KevinOleniczak/Windfarm-hardware/turbine/models/DC-Motor With Rotor/Render/Bearing2.jpg

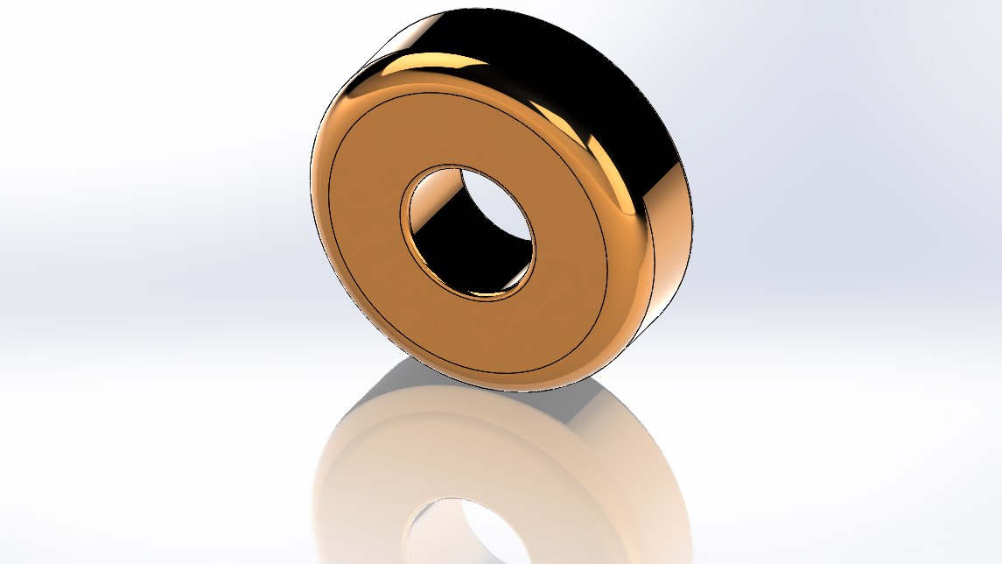
turbine/models/DC-Motor With Rotor/Render/Bearing2.jpg
