KevinOleniczak/Windfarm-hardware/turbine/models/DC-Motor With Rotor/Render/Bearing.jpg

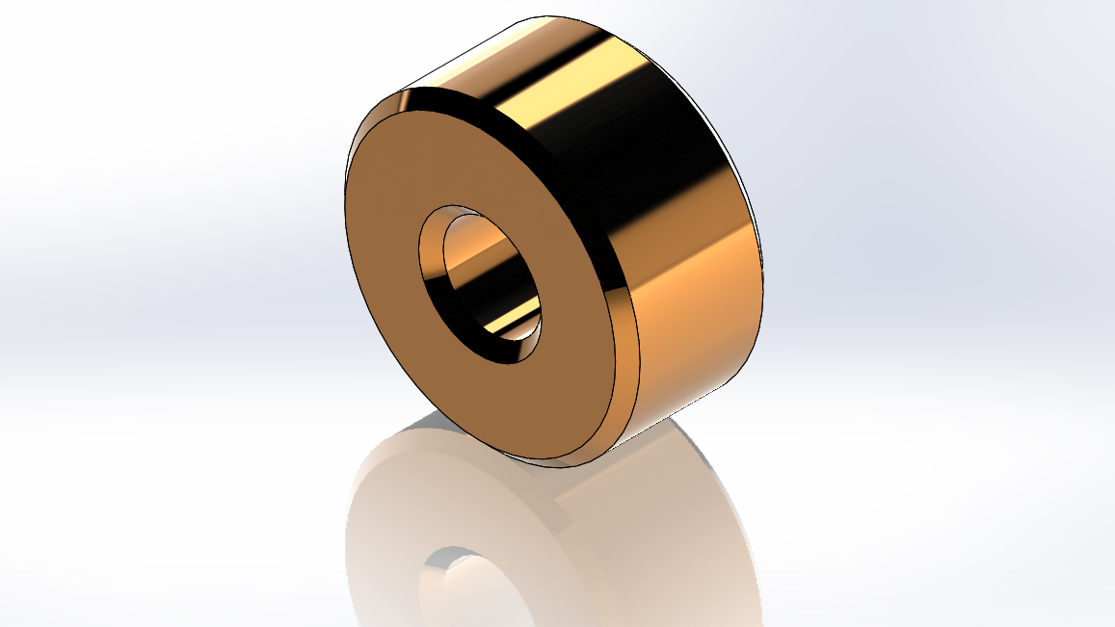
turbine/models/DC-Motor With Rotor/Render/Bearing.jpg
