KevinOleniczak/Windfarm-hardware/turbine/models/DC-Motor With Rotor/Render/Brush.jpg

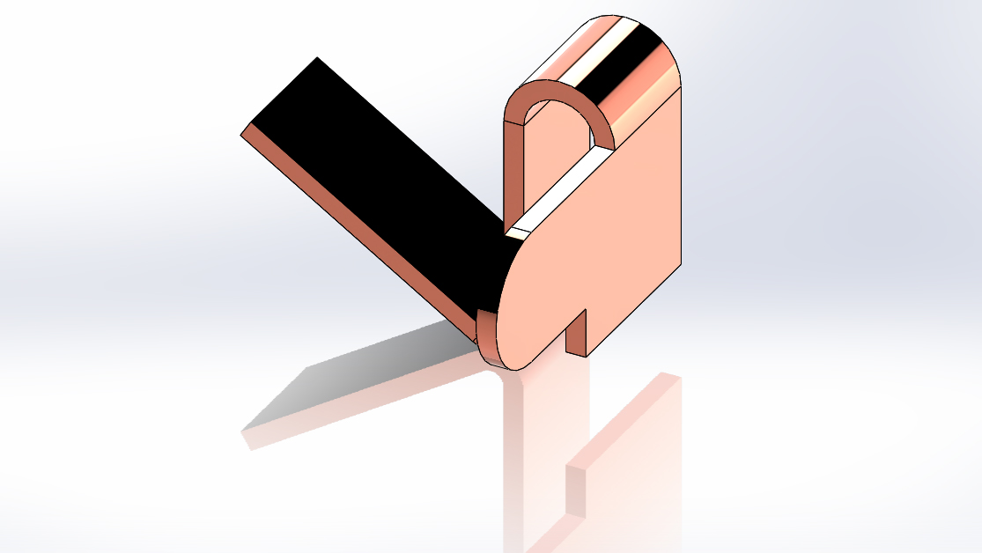
turbine/models/DC-Motor With Rotor/Render/Brush.jpg
