KevinOleniczak/Windfarm-hardware/turbine/models/DC-Motor With Rotor/Render/DC Motor 1.jpg

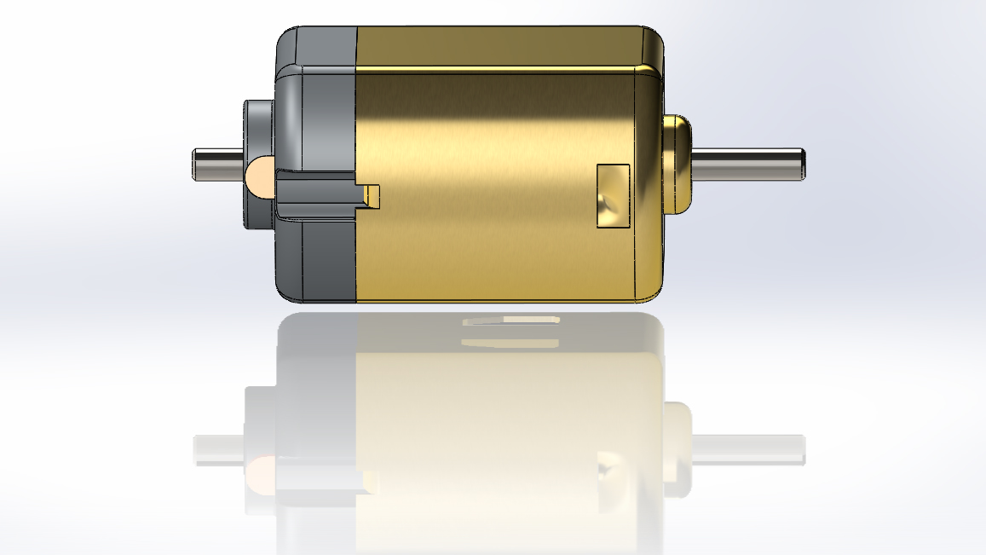
turbine/models/DC-Motor With Rotor/Render/DC Motor 1.jpg
