KevinOleniczak/Windfarm-hardware/turbine/models/DC-Motor With Rotor/Render/DC Motor Back Isometric View.jpg

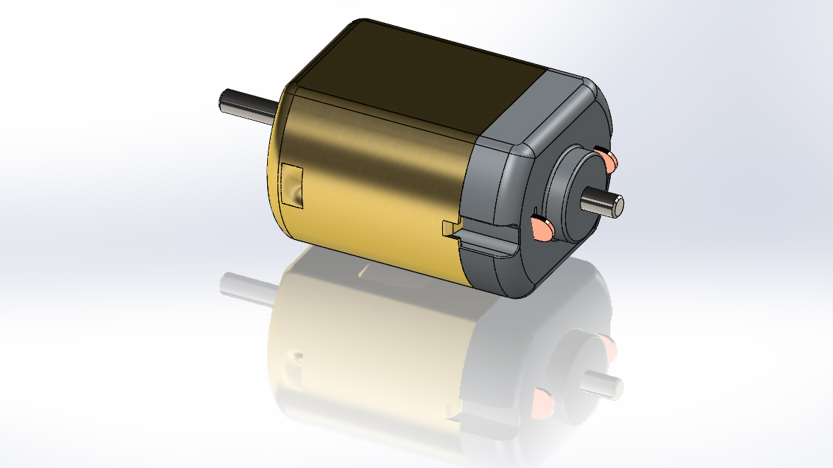
turbine/models/DC-Motor With Rotor/Render/DC Motor Back Isometric View.jpg
