KevinOleniczak/Windfarm-hardware/turbine/models/DC-Motor With Rotor/Render/DC Motor Front-Top View.jpg

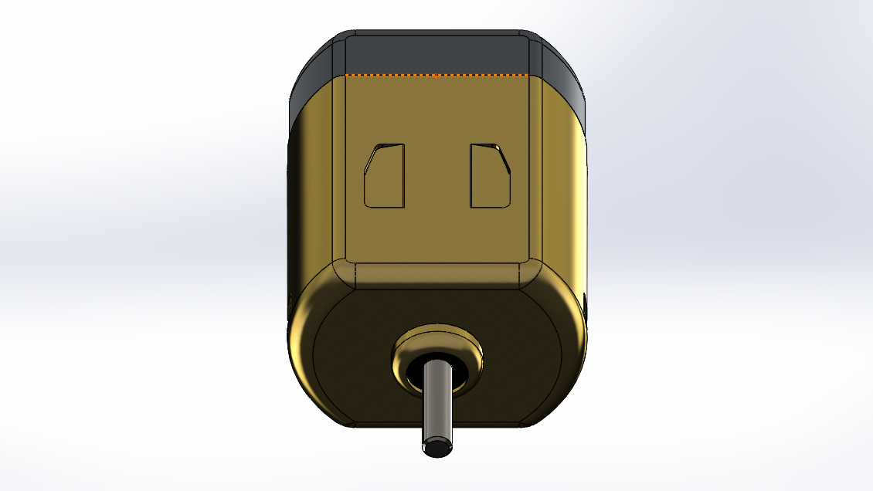
turbine/models/DC-Motor With Rotor/Render/DC Motor Front-Top View.jpg
