KevinOleniczak/Windfarm-hardware/turbine/models/DC-Motor With Rotor/Render/DC Motor Isometric View.jpg

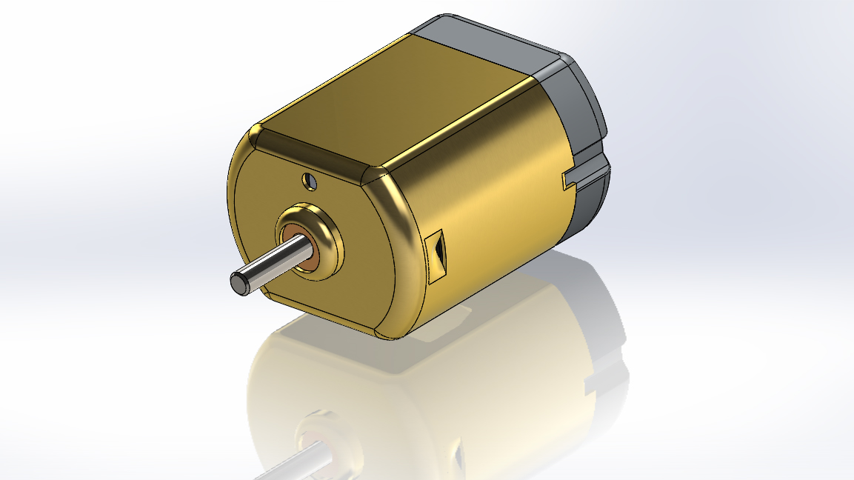
turbine/models/DC-Motor With Rotor/Render/DC Motor Isometric View.jpg
