KevinOleniczak/Windfarm-hardware/turbine/models/DC-Motor With Rotor/Render/DC Motor Rotor Final Render.JPG

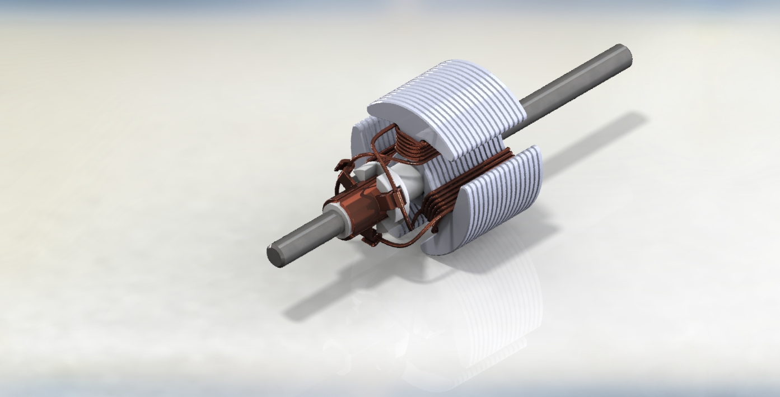
turbine/models/DC-Motor With Rotor/Render/DC Motor Rotor Final Render.JPG
