KevinOleniczak/Windfarm-hardware/turbine/models/DC-Motor With Rotor/Render/DC Motor Rotor.jpg

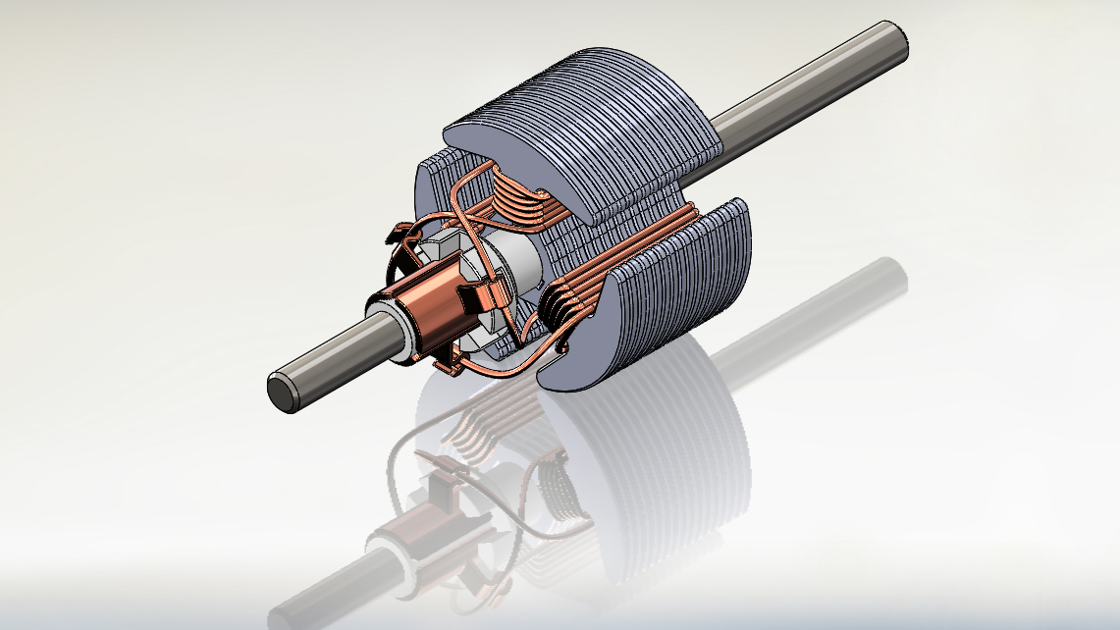
turbine/models/DC-Motor With Rotor/Render/DC Motor Rotor.jpg
