KevinOleniczak/Windfarm-hardware/turbine/models/DC-Motor With Rotor/Render/DC-Motor Case.jpg

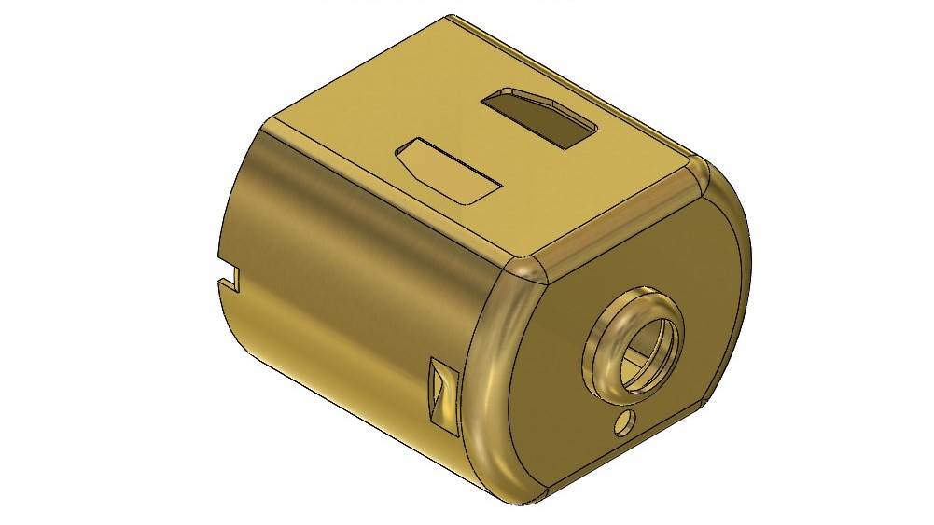
turbine/models/DC-Motor With Rotor/Render/DC-Motor Case.jpg
