KevinOleniczak/Windfarm-hardware/turbine/models/DC-Motor With Rotor/Render/Magnet.jpg

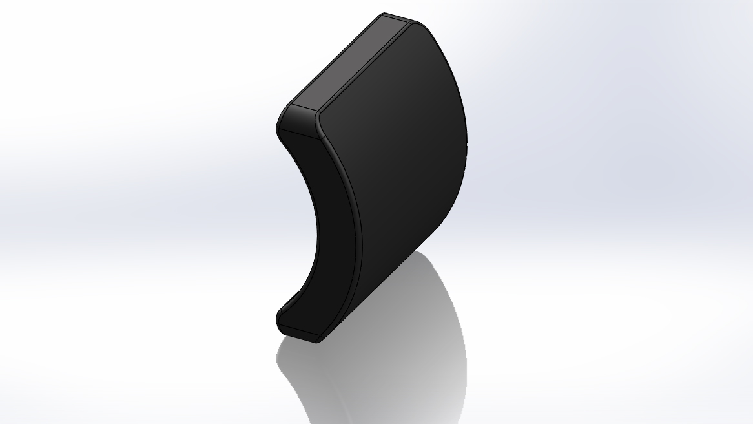
turbine/models/DC-Motor With Rotor/Render/Magnet.jpg
