KevinOleniczak/Windfarm-hardware/turbine/models/DC-Motor With Rotor/Render/Motor Cover.jpg

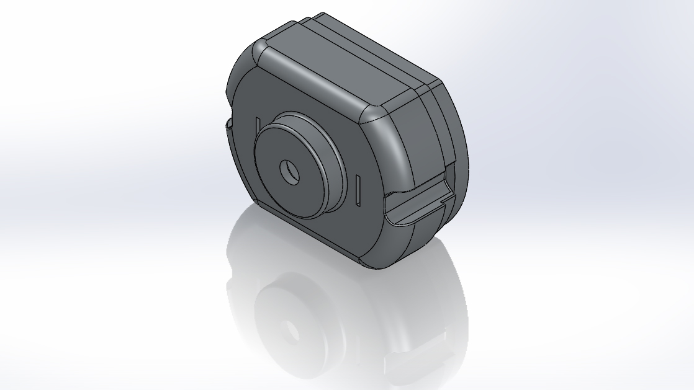
turbine/models/DC-Motor With Rotor/Render/Motor Cover.jpg
