KevinOleniczak/Windfarm-hardware/turbine/models/DC-Motor With Rotor/Render/Seperator.jpg

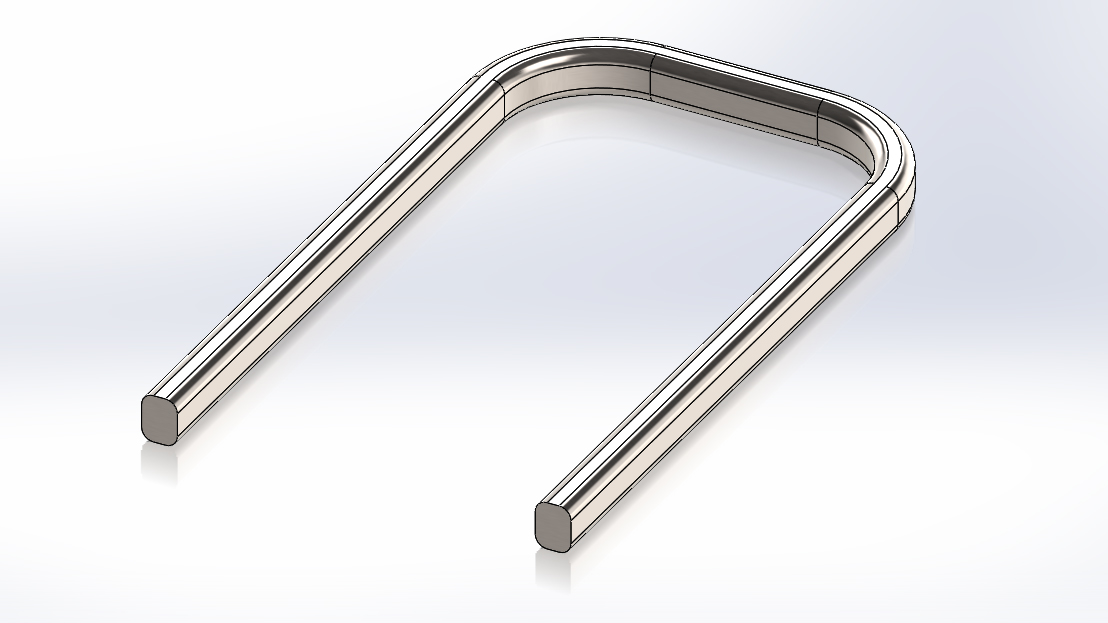
turbine/models/DC-Motor With Rotor/Render/Seperator.jpg
