KevinOleniczak/Windfarm-hardware/turbine/rpi-zero-shield/asbuilt2.jpg

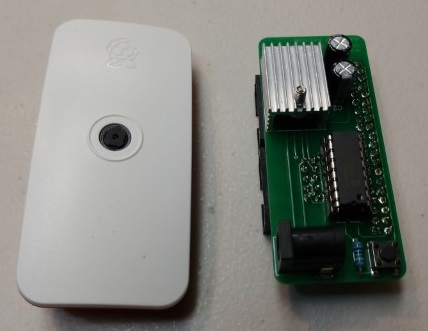
turbine/rpi-zero-shield/asbuilt2.jpg
