KevinOleniczak/Windfarm-hardware/turbine/rpi-zero-shield/asbuilt4.jpg

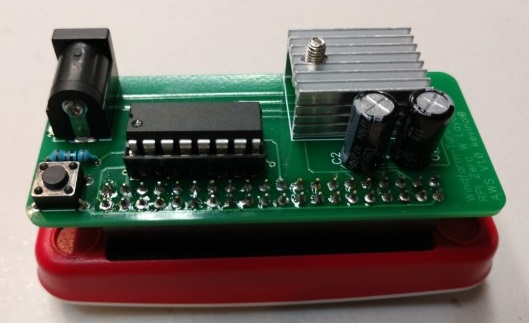
turbine/rpi-zero-shield/asbuilt4.jpg
