KevinOleniczak/Windfarm-hardware/turbine/rpi-zero-shield/left_3d.png

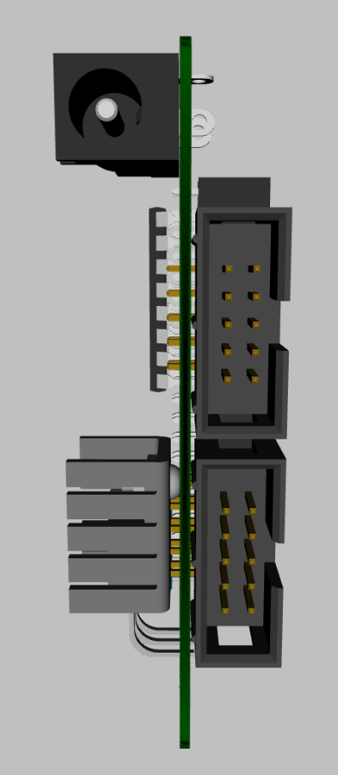
turbine/rpi-zero-shield/left_3d.png
