KevinOleniczak/Windfarm-hardware/turbine/rpi-zero-shield/top_edge_3d.png

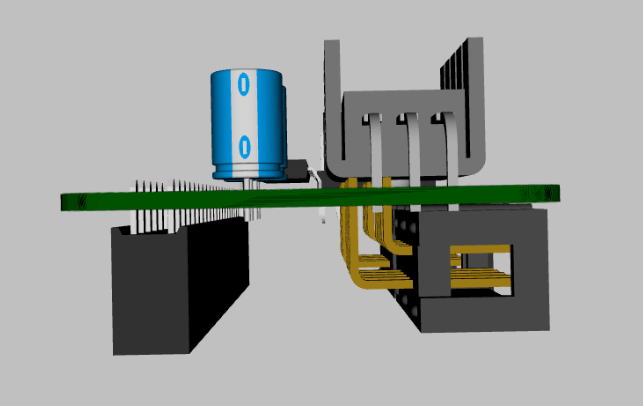
turbine/rpi-zero-shield/top_edge_3d.png
