KevinOleniczak/Windfarm-hardware/turbine/sumerian_turbine.png

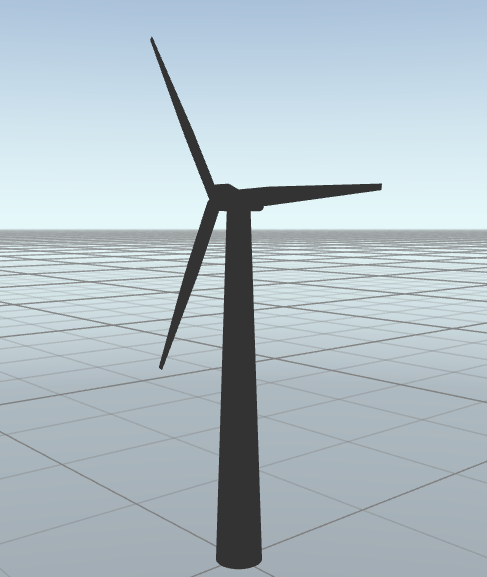
turbine/sumerian_turbine.png
