KevinOleniczak/Windfarm-hardware/turbine/models/Led RGB 5mm/to-92s-3.stp.SLDASM

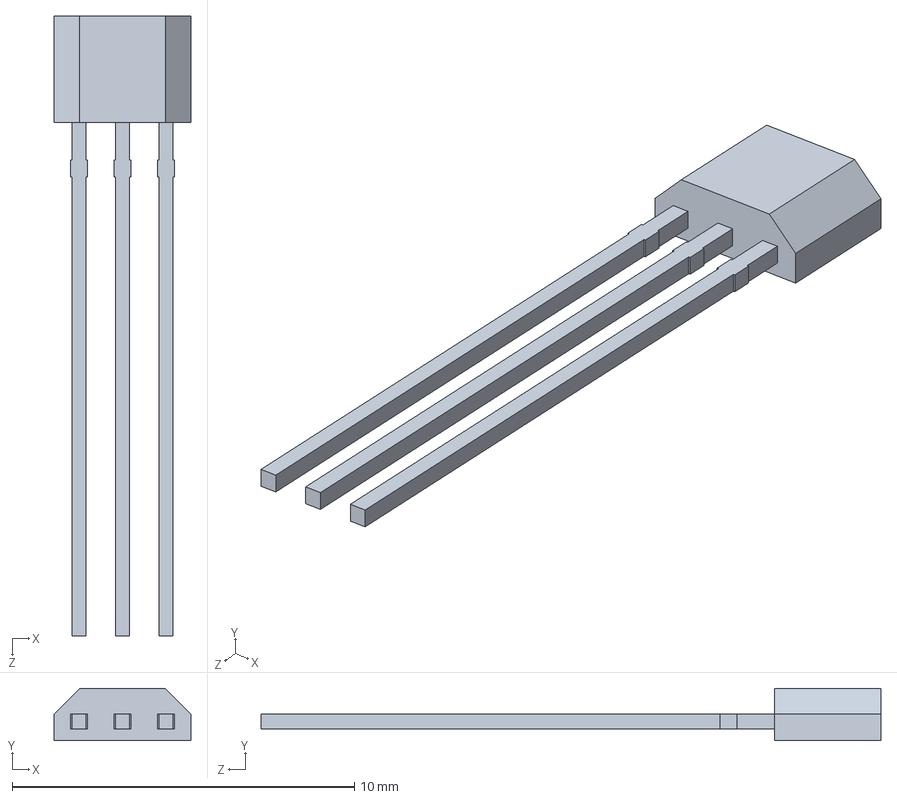
[picture p40: CAD file, 2018-11-25]
turbine/models/Led RGB 5mm/to-92s-3.stp.SLDASM
4.00 x 1.52 x 18.1 mm
