KevinOleniczak/Windfarm-hardware/turbine/models/9g Servo/servo.SLDASM

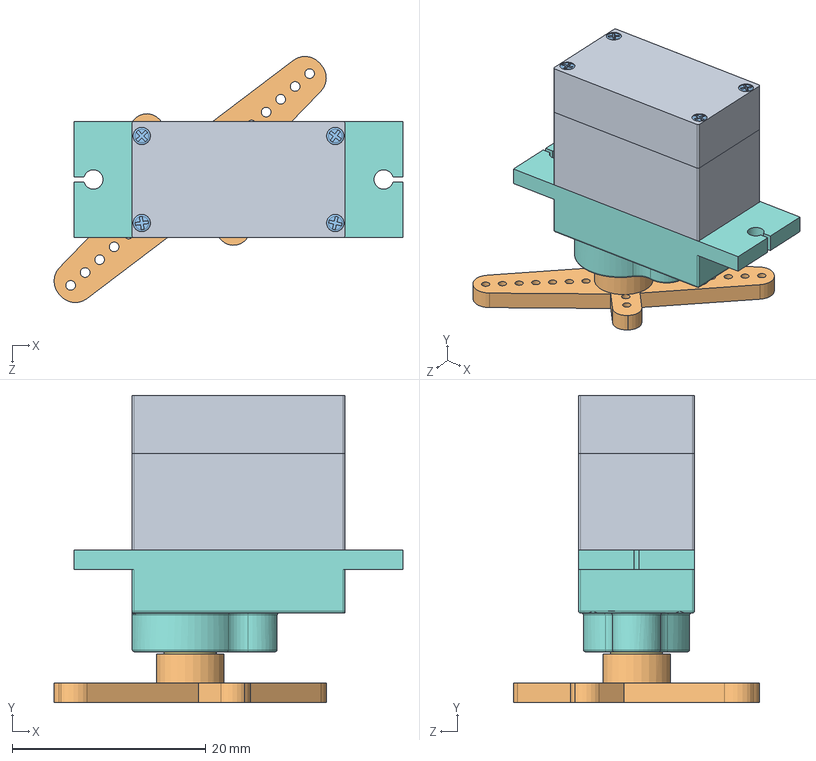
[picture p41: CAD file, 2018-11-25]
turbine/models/9g Servo/servo.SLDASM
36.1 x 31.8 x 25.4 mm
middleShell
motor
port
gear1
gear2
gear3
gear4
upperShell
lowerShell
arm1
nut x 4
nut2
