KevinOleniczak/Windfarm-hardware/turbine/models/9g Servo/gear1.SLDPRT

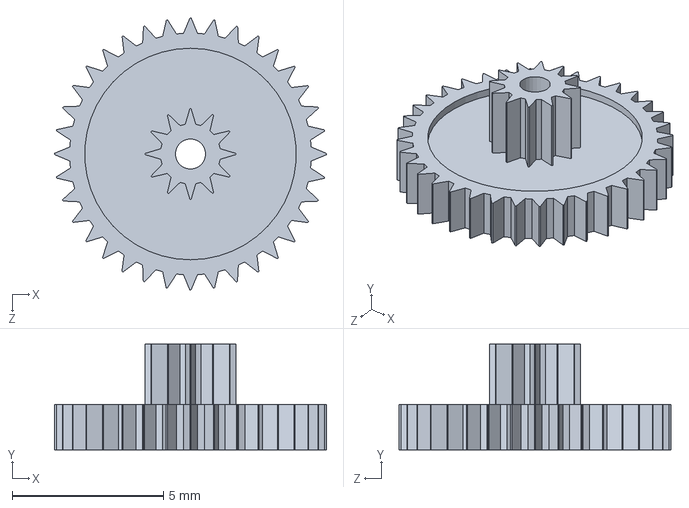
[picture p42: CAD file, 2018-11-25]
turbine/models/9g Servo/gear1.SLDPRT
9.00 x 3.50 x 9.00 mm
