KevinOleniczak/Windfarm-hardware/turbine/models/conn_board_3d.step

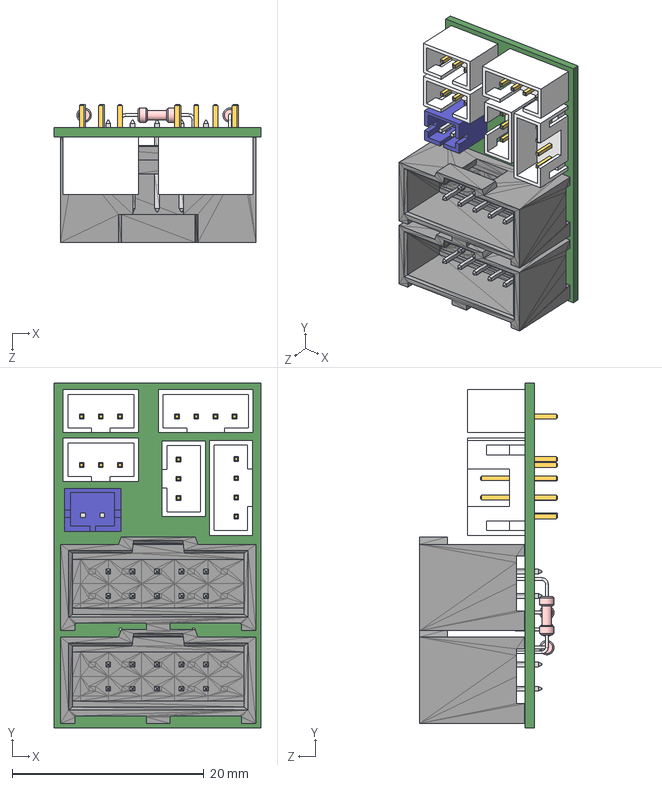
[picture p43: CAD file, 2018-11-25]
turbine/models/conn_board_3d.step
21.6 x 36.0 x 14.4 mm
Board_conn_board_3d
JST_Socket_3_Pin x 3
JST_Socket_4_Pin x 2
B2B-PH-K-S
res-7.62_4x1.5 x 5
idc10m x 2
