KevinOleniczak/Windfarm-hardware/turbine/models/DC-Motor With Rotor/DC Motor Case.SLDPRT

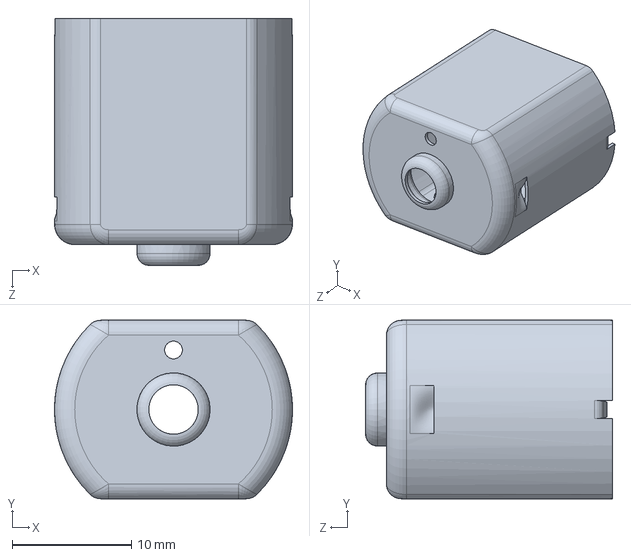
[picture p44: CAD file, 2018-11-25]
turbine/models/DC-Motor With Rotor/DC Motor Case.SLDPRT
20.0 x 15.0 x 20.8 mm
