KevinOleniczak/Windfarm-hardware/turbine/models/9g Servo/gear3.SLDPRT

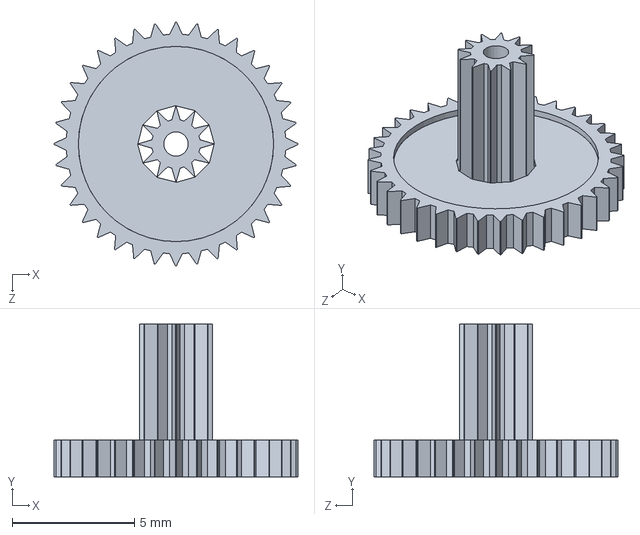
[picture p45: CAD file, 2018-11-25]
turbine/models/9g Servo/gear3.SLDPRT
10.00 x 6.25 x 10.00 mm
