KevinOleniczak/Windfarm-hardware/turbine/models/DC-Motor With Rotor/Brush.SLDPRT

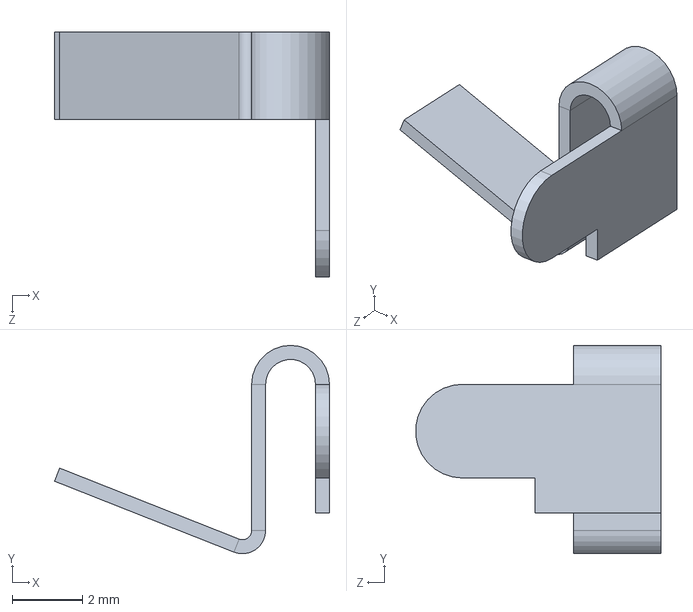
[picture p46: CAD file, 2018-11-25]
turbine/models/DC-Motor With Rotor/Brush.SLDPRT
7.84 x 5.94 x 6.99 mm
