KevinOleniczak/Windfarm-hardware/turbine/models/fin_blade.obj

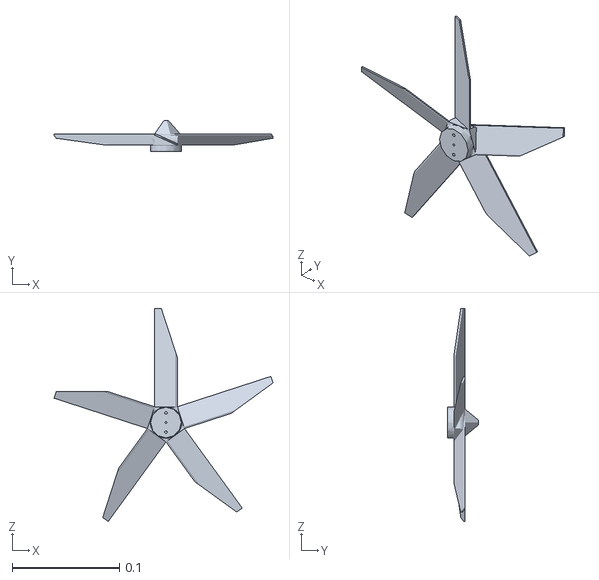
[picture p47: CAD file, 2018-11-06]
turbine/models/fin_blade.obj
0.204 x 0.0292 x 0.198
