KevinOleniczak/Windfarm-hardware/turbine/models/Led RGB 5mm/Led RGB 5mm.STEP

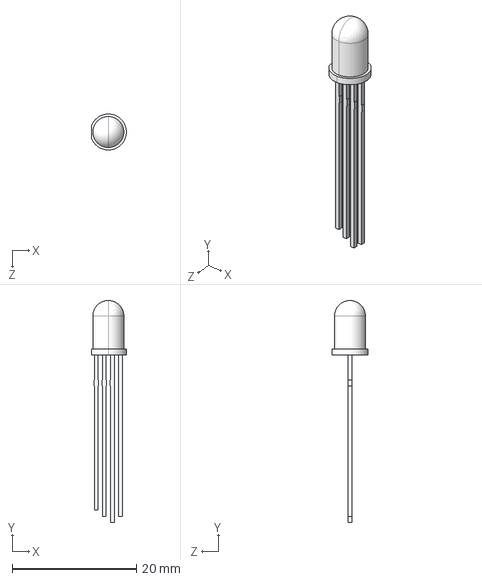
[picture p48: CAD file, 2018-11-25]
turbine/models/Led RGB 5mm/Led RGB 5mm.STEP
5.60 x 35.8 x 5.80 mm
Lente^Led RGB 5mm
Terminais^Led RGB 5mm
