KevinOleniczak/Windfarm-hardware/turbine/models/9g Servo/arm1.SLDPRT

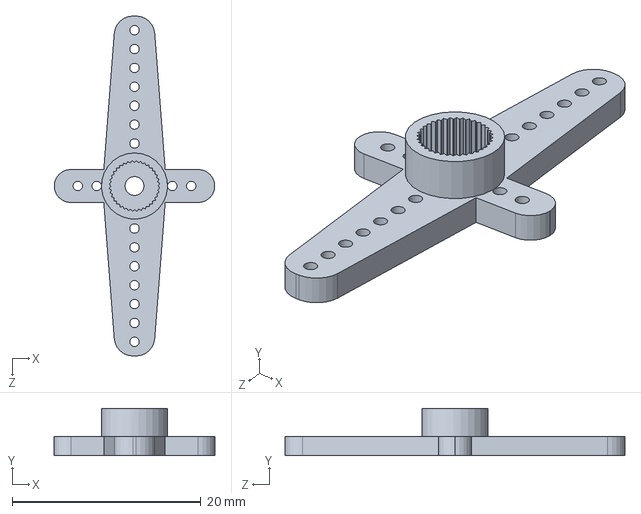
[picture p49: CAD file, 2018-11-25]
turbine/models/9g Servo/arm1.SLDPRT
17.0 x 5.00 x 36.0 mm
