KevinOleniczak/Windfarm-hardware/turbine/models/DC-Motor With Rotor/Bearing 1.SLDPRT

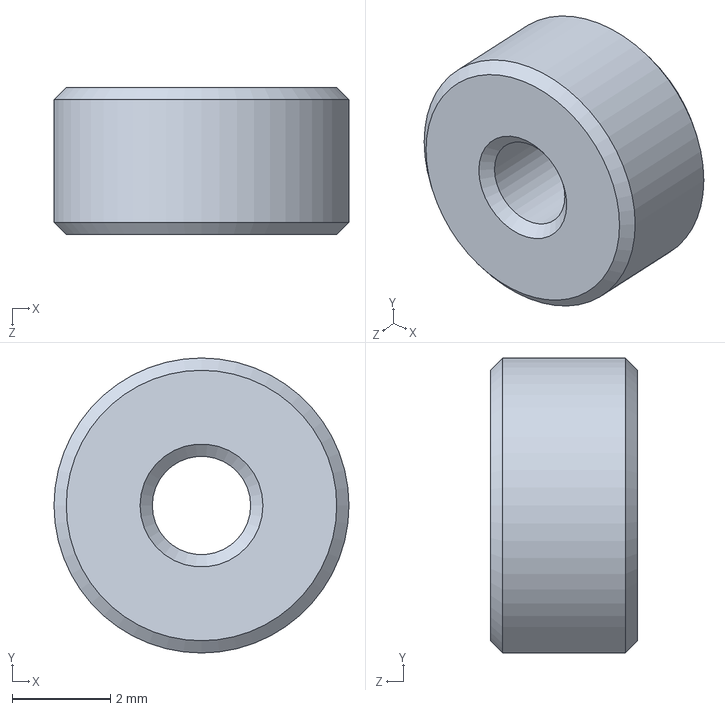
[picture p50: CAD file, 2018-11-25]
turbine/models/DC-Motor With Rotor/Bearing 1.SLDPRT
6.00 x 6.00 x 3.00 mm
