KevinOleniczak/Windfarm-hardware/turbine/models/mast.obj

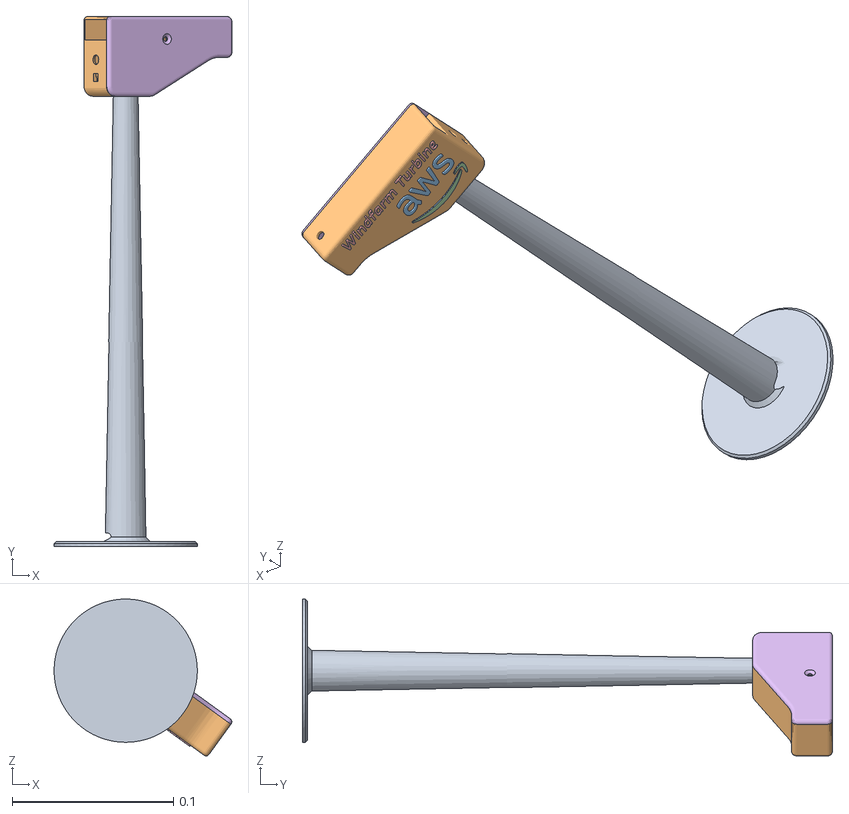
[picture p51: CAD file, 2018-11-06]
turbine/models/mast.obj
0.11 x 0.329 x 0.0973
mesh 1 mast_v2a-2
mesh 2 mast_v2b-3
mesh 3 head_v2.1-2
mesh 4 Fillet10
mesh 5 Chamfer2
mesh 6 Boss-Extrude11
