KevinOleniczak/Windfarm-hardware/turbine/models/DC-Motor With Rotor/Separator.SLDPRT

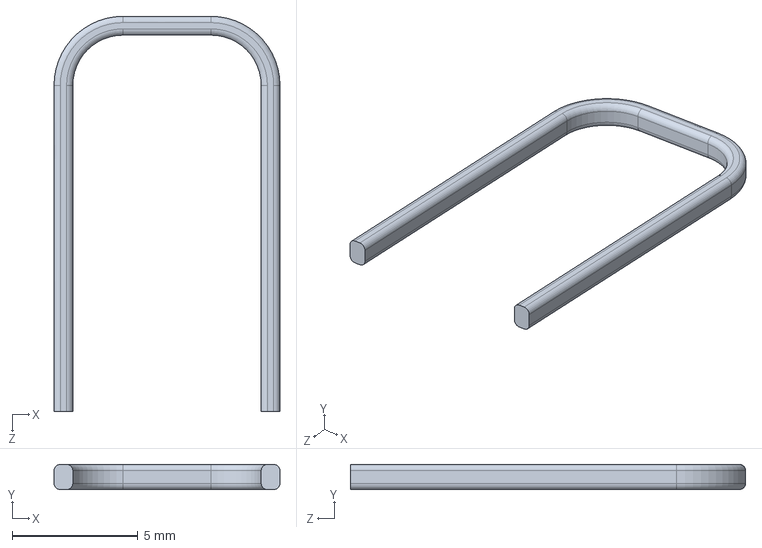
[picture p52: CAD file, 2018-11-25]
turbine/models/DC-Motor With Rotor/Separator.SLDPRT
9.00 x 1.00 x 15.8 mm
