KevinOleniczak/Windfarm-hardware/turbine/models/9g Servo/upperShell.SLDPRT

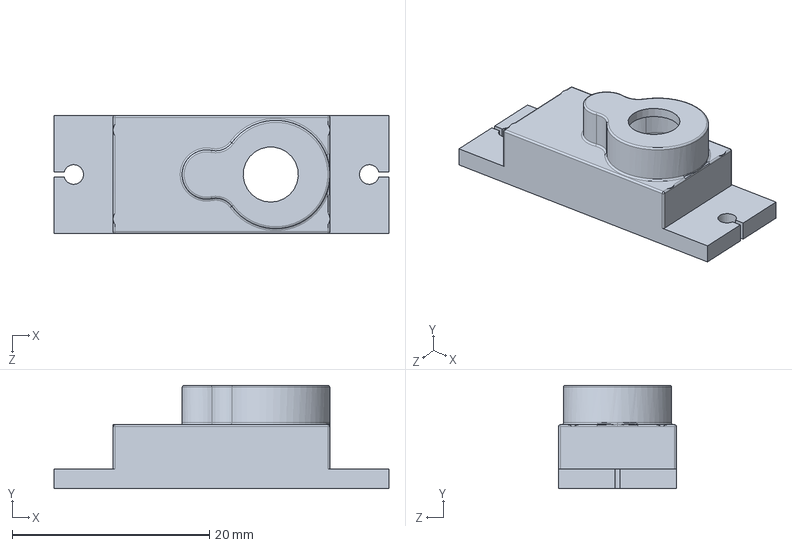
[picture p53: CAD file, 2018-11-25]
turbine/models/9g Servo/upperShell.SLDPRT
34.0 x 10.5 x 12.0 mm
