KevinOleniczak/Windfarm-hardware/turbine/models/DC-Motor With Rotor/Magnet.SLDPRT

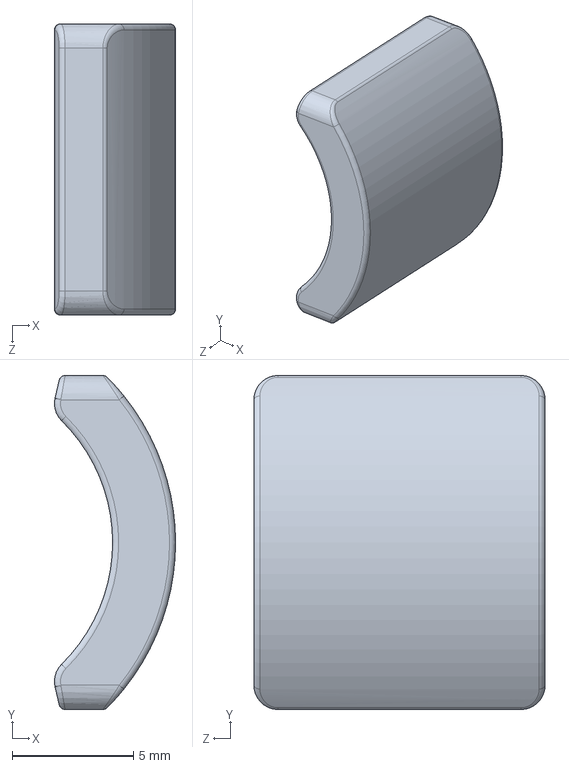
[picture p54: CAD file, 2018-11-25]
turbine/models/DC-Motor With Rotor/Magnet.SLDPRT
4.99 x 13.8 x 12.0 mm
