KevinOleniczak/Windfarm-hardware/turbine/models/mast_b.STL

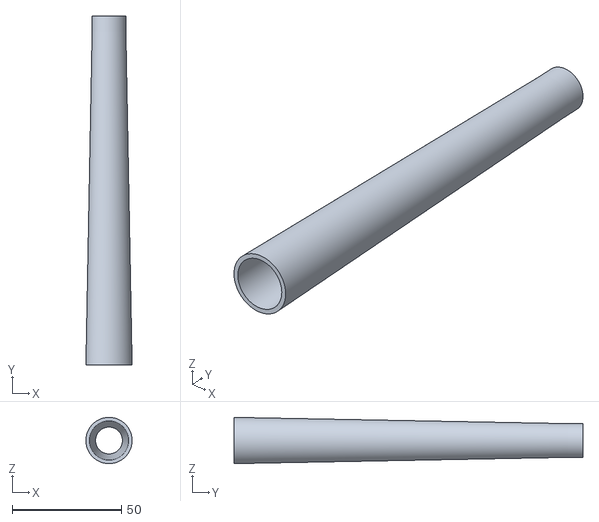
[picture p55: CAD file, 2018-10-22]
turbine/models/mast_b.STL
21.1 x 159.5 x 21.1
