KevinOleniczak/Windfarm-hardware/turbine/models/9g Servo/motor.SLDPRT

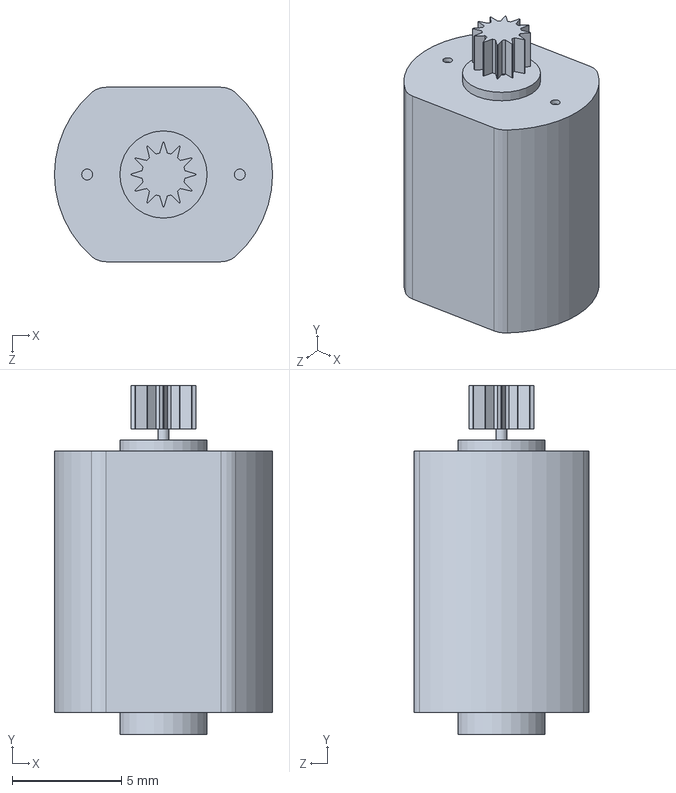
[picture p56: CAD file, 2018-11-25]
turbine/models/9g Servo/motor.SLDPRT
10.0 x 16.0 x 8.00 mm
