KevinOleniczak/Windfarm-hardware/turbine/models/DC-Motor With Rotor/DC Motor Cover.SLDPRT

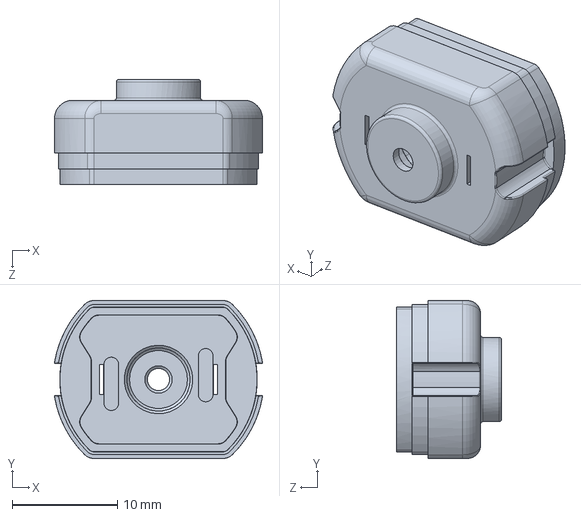
[picture p57: CAD file, 2018-11-25]
turbine/models/DC-Motor With Rotor/DC Motor Cover.SLDPRT
19.7 x 15.0 x 10.0 mm
