KevinOleniczak/Windfarm-hardware/turbine/models/9g Servo/port.SLDPRT

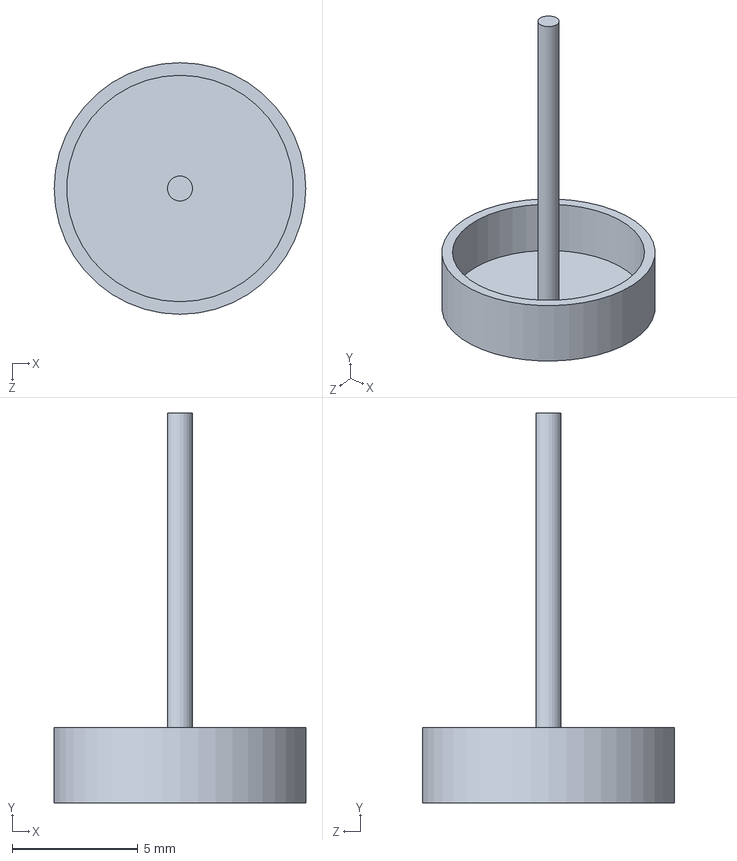
[picture p58: CAD file, 2018-11-25]
turbine/models/9g Servo/port.SLDPRT
10.0 x 15.5 x 10.0 mm
