KevinOleniczak/Windfarm-hardware/turbine/models/DC-Motor With Rotor/Bearing 2.SLDPRT

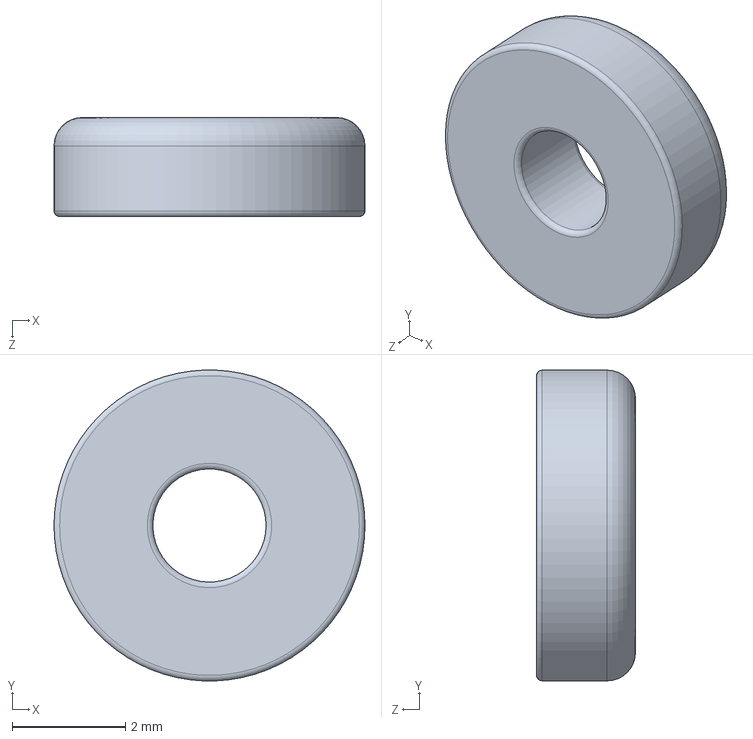
[picture p59: CAD file, 2018-11-25]
turbine/models/DC-Motor With Rotor/Bearing 2.SLDPRT
5.50 x 5.50 x 1.75 mm
