KevinOleniczak/Windfarm-hardware/turbine/models/9g Servo/nut2.SLDPRT

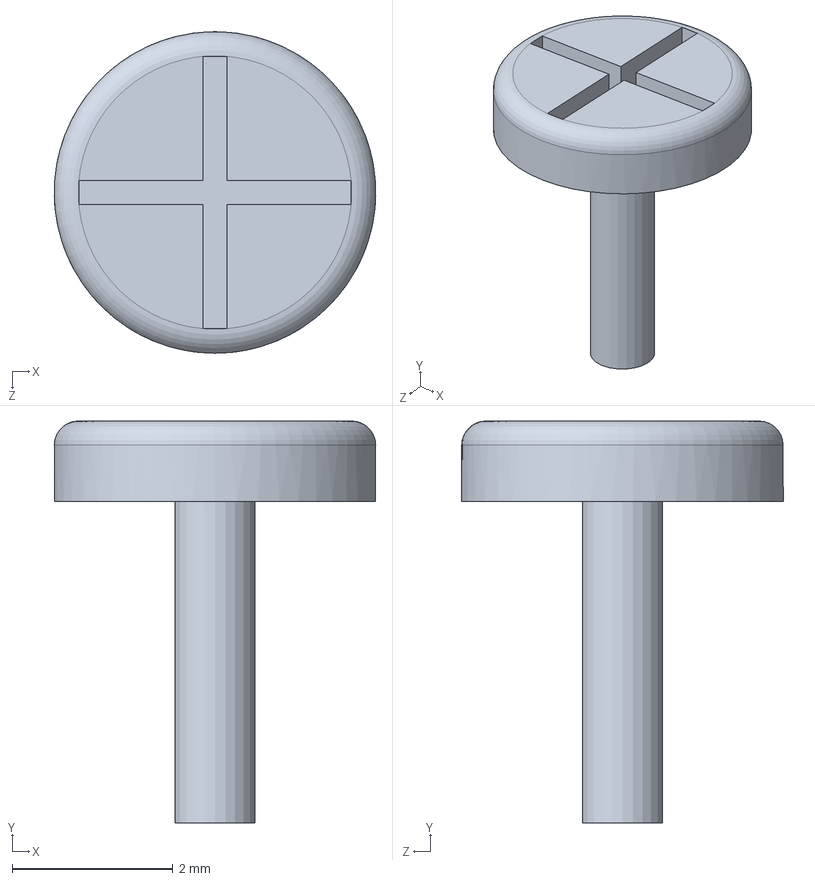
[picture p60: CAD file, 2018-11-25]
turbine/models/9g Servo/nut2.SLDPRT
4.00 x 5.00 x 4.00 mm
