KevinOleniczak/Windfarm-hardware/turbine/models/9g Servo/middleShell.SLDPRT

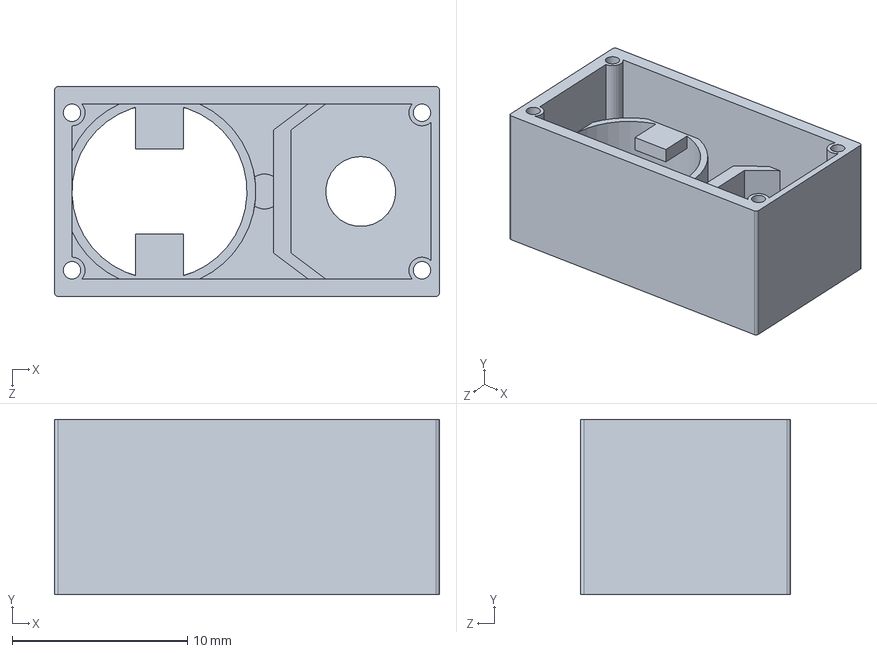
[picture p61: CAD file, 2018-11-25]
turbine/models/9g Servo/middleShell.SLDPRT
22.0 x 10.0 x 12.0 mm
