KevinOleniczak/Windfarm-hardware/turbine/models/9g Servo/gear4.SLDPRT

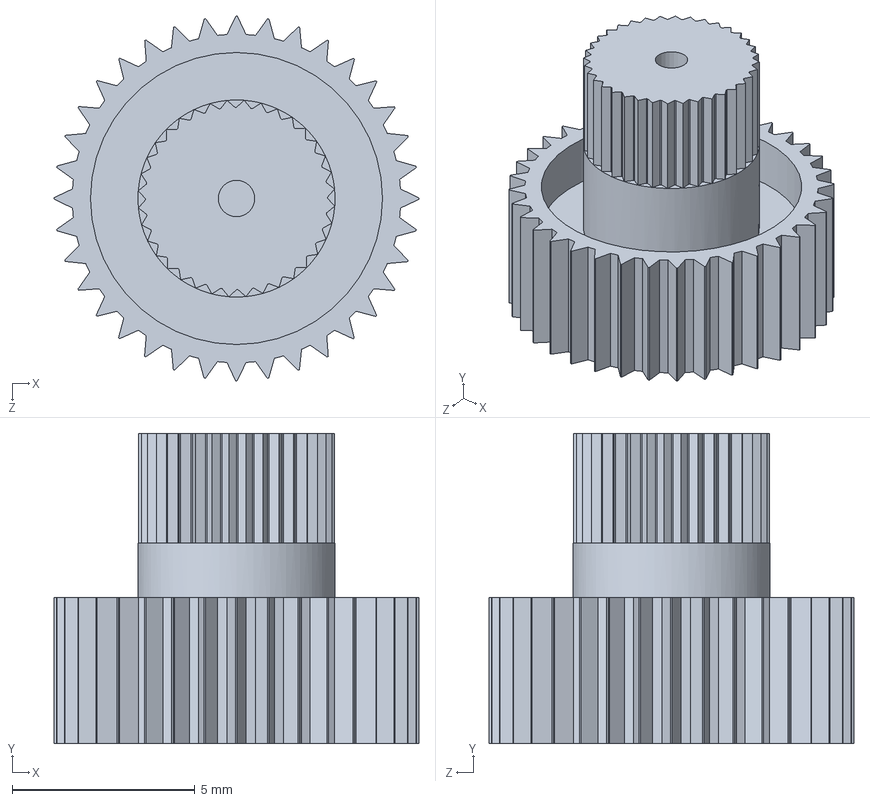
[picture p62: CAD file, 2018-11-25]
turbine/models/9g Servo/gear4.SLDPRT
10.00 x 8.50 x 10.00 mm
