KevinOleniczak/Windfarm-hardware/turbine/models/9g Servo/lowerShell.SLDPRT

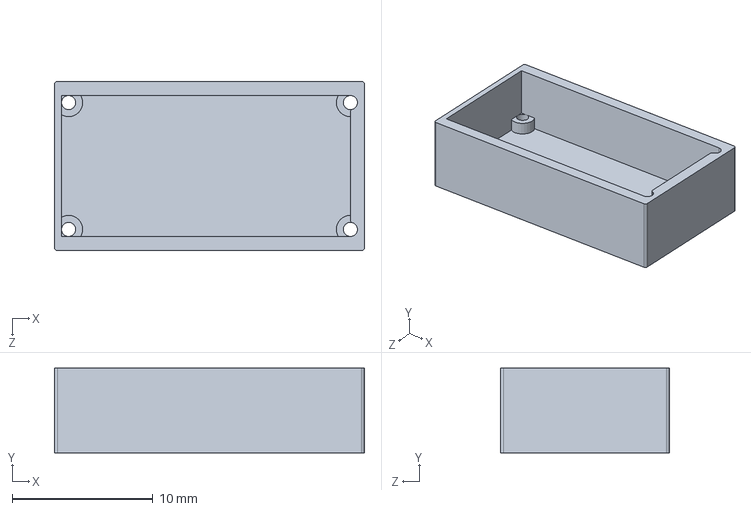
[picture p63: CAD file, 2018-11-25]
turbine/models/9g Servo/lowerShell.SLDPRT
22.0 x 6.00 x 12.0 mm
