KevinOleniczak/Windfarm-hardware/turbine/models/9g Servo/upperShell2.SLDPRT

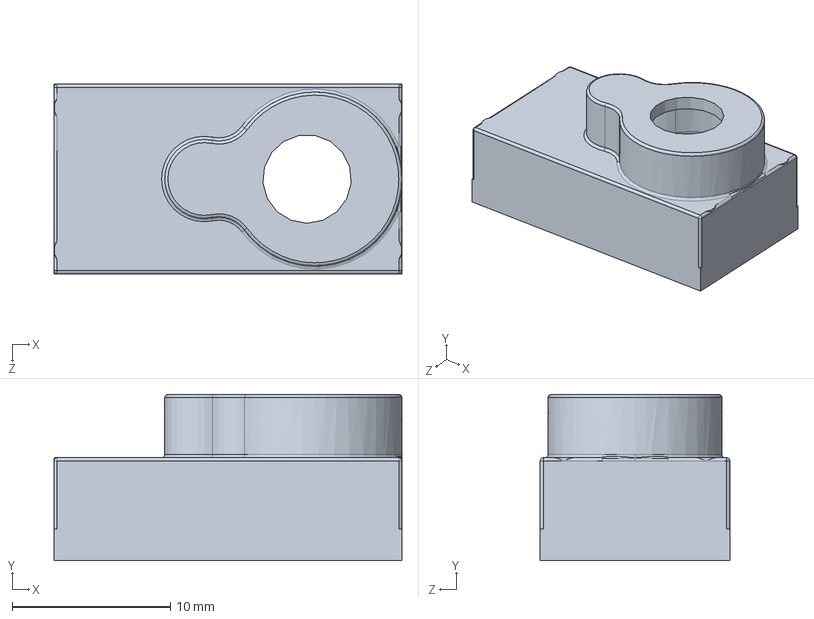
[picture p64: CAD file, 2018-11-25]
turbine/models/9g Servo/upperShell2.SLDPRT
22.0 x 10.5 x 12.0 mm
