KevinOleniczak/Windfarm-hardware/turbine/models/9g Servo/gear2.SLDPRT

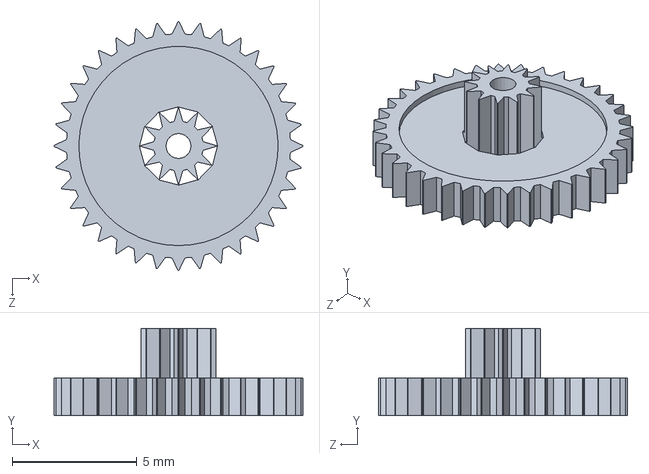
[picture p65: CAD file, 2018-11-25]
turbine/models/9g Servo/gear2.SLDPRT
10.00 x 3.50 x 10.00 mm
