KevinOleniczak/Windfarm-hardware/turbine/models/9g Servo/arm2.SLDPRT

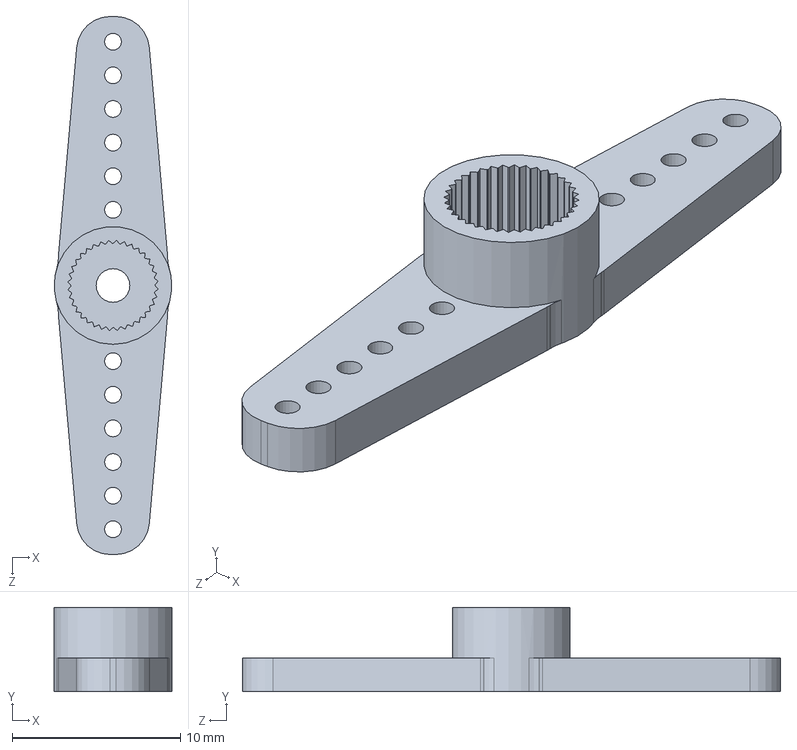
[picture p66: CAD file, 2018-11-25]
turbine/models/9g Servo/arm2.SLDPRT
6.99 x 5.00 x 32.0 mm
