KevinOleniczak/Windfarm-hardware/turbine/models/9g Servo/arm3.SLDPRT

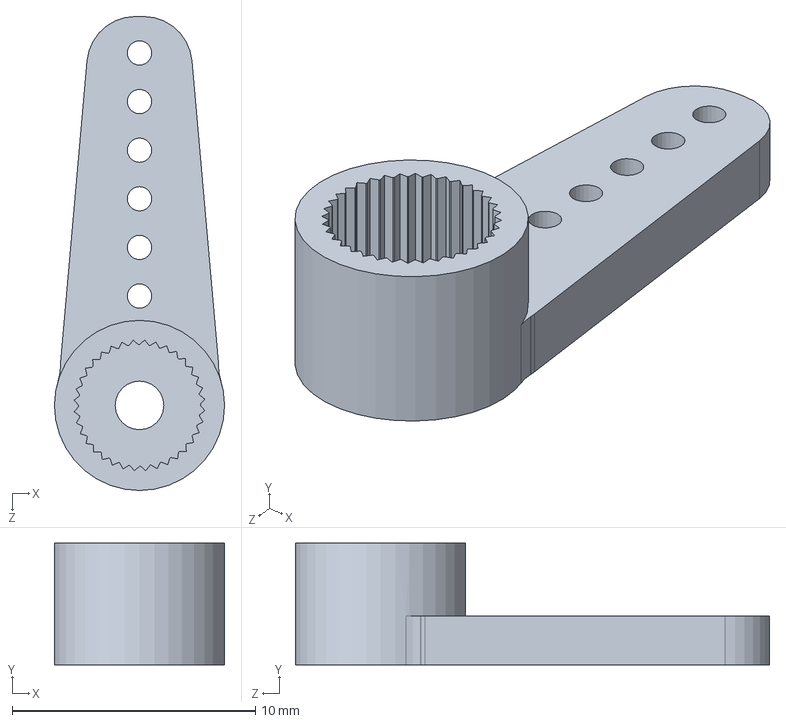
[picture p67: CAD file, 2018-11-25]
turbine/models/9g Servo/arm3.SLDPRT
7.00 x 5.00 x 19.5 mm
