KevinOleniczak/Windfarm-hardware/(list of files, cad)

Other CAD files:
turbine/models/Led RGB 5mm/to-92s-3-prt0.stp.SLDPRT
turbine/models/9g Servo/nut.SLDPRT
turbine/models/Led RGB 5mm/Led RGB 5mm.SLDASM
turbine/models/conn_board_3d(1).step
