KevinOleniczak/Windfarm-hardware/(list of files, drawings)

Other design files:
turbine/conn-board/windturbine_conn_board.dch
turbine/conn-board/windturbine_conn_board.dip
turbine/rpi-zero-shield/windturbine_rpi_shield_v1.0.dch
turbine/rpi-zero-shield/windturbine_rpi_shield_v1.0.dip
