KevinOleniczak/Windfarm-hardware/(commit log)

2018-10-22 initial checkin
    [Assem2.SLDASM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]
2019-05-19 adding missing fin blade stl file
